bbsmith24/YamuraPyrometer/Doumentation and notes/TFT pinout back.JPG

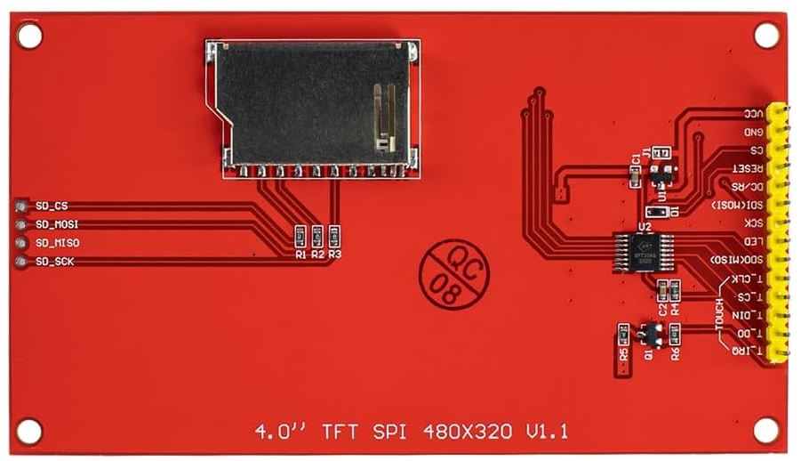
Doumentation and notes/TFT pinout back.JPG
