bbsmith24/YamuraPyrometer/Doumentation and notes/TFT pinout front.JPG

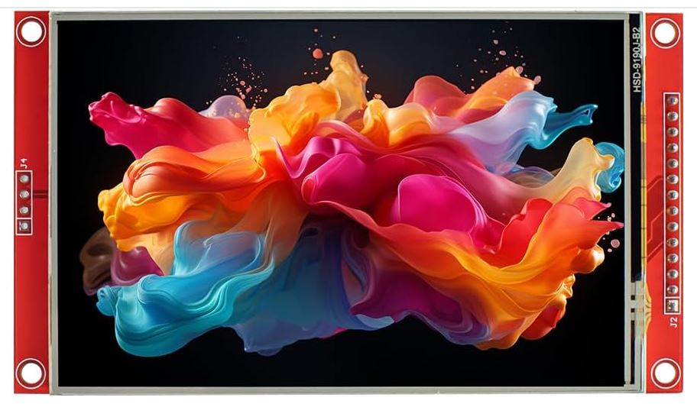
Doumentation and notes/TFT pinout front.JPG
