bbsmith24/YamuraPyrometer/Doumentation and notes/fusion schematic v2.pdf

## 4/5/2025 5:19 PM (Sheet: 1/1)

### ESP32-DEVKITC-32D

### JST-XH-2PIN

### JST-XH-4PIN

U1
3V3 J2-1 | EN J2-2 | SENSOR_VP J2-3 | SENSOR_VN J2-4

IO34 J2-5
IO35 J2-6
IO32 J2-7
IO33 J2-8
IO25 J2-9
IO26 J2-10
IO27 J2-11
IO14 J2-12
IO12 J2-13 | GND1 J2-14
IO13 J2-15 | SD2 J2-16 | SD3 J2-17 | CMD J2-18 | EXT_5V J2-19 | CLK | J3-19 SD0 | J3-18 SD1 | J3-17 IO15 | J3-16 IO2 | J3-15 IO0 | J3-14 IO4 | J3-13 IO16 | J3-12 IO17 | J3-11 IO5 | J3-10 IO18 | J3-9 IO19 | J3-8 GND2 | J3-7 IO21 | J3-6 RXD0 | J3-5 TXD0 | J3-4 IO22 | J3-3 IO23 | J3-2 GND3 | J3-1

LED LED
SDO SDO
SCK SCK | SDI SDI | DC_RS DC_RS | RESET RESET | CS CS | GND GND | VCC VCC

T_CLK T_CKL
T_CS T_CS
T_DIN T_DIN
T_DO T_DO
T_IRQ T_IRQ
SD_SDI | SD_DO SD_CS | SD_CS
SD_SDO | | SD_SCK
SD_SCK | | SD_DI
4" TFT DISPLAY A¹ A¹ SDA SDA | A² A² SCL SCL GND GND VIN VIN | A³ A³ A⁴ A⁴ ADDR ADDR
MPC9601 | 32K ³²K SQW SQW SCL SCL SDA SDA VCC VCC GND GND | SCL1 SCL1 SDA¹ SDA¹ VCC¹ VCC¹ GND¹ GND¹ | DS³²³¹

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
# 4 D1
