bbsmith24/YamuraPyrometer/Doumentation and notes/ESP32 dev kit pinout.JPG

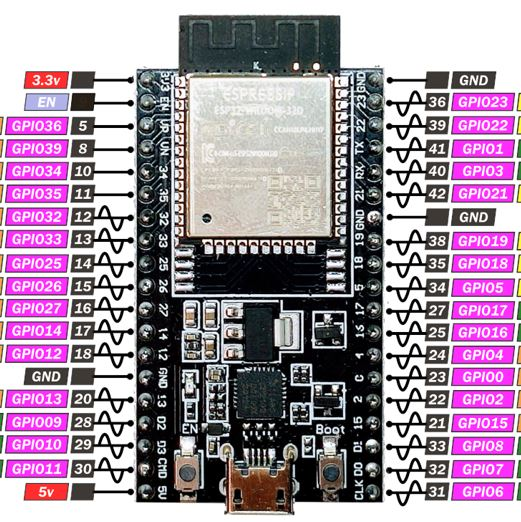
Doumentation and notes/ESP32 dev kit pinout.JPG
