bbsmith24/YamuraPyrometer/Doumentation and notes/fusion board bottom.JPG

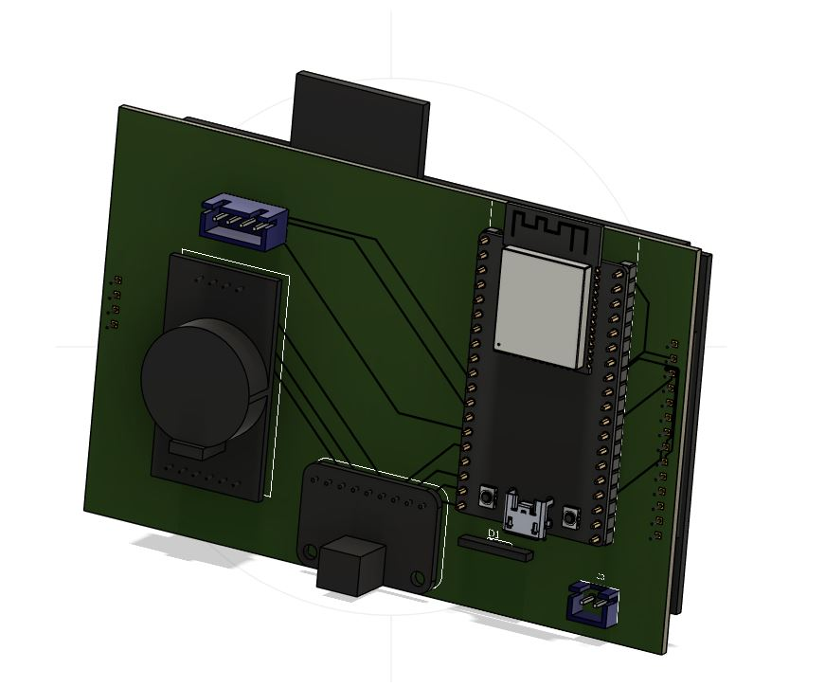
Doumentation and notes/fusion board bottom.JPG
