bbsmith24/YamuraPyrometer/Doumentation and notes/fusion board top.JPG

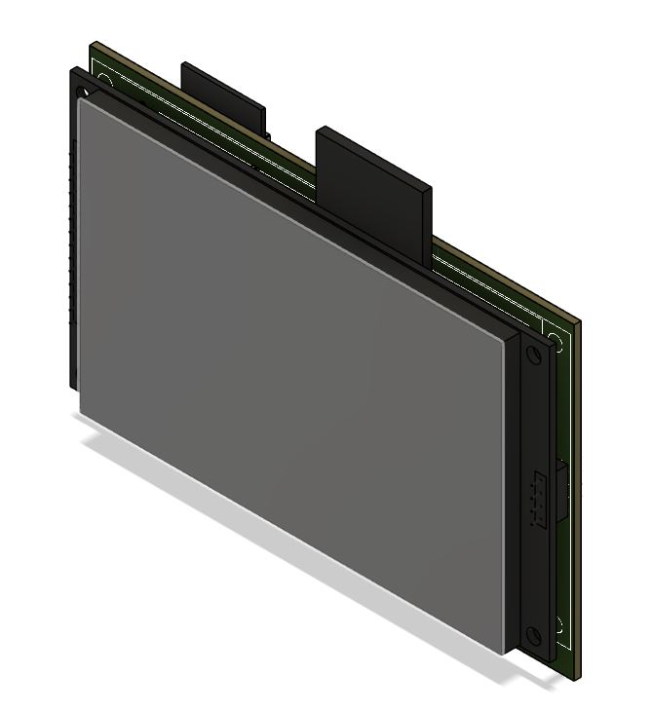
Doumentation and notes/fusion board top.JPG
