bbsmith24/YamuraPyrometer/Doumentation and notes/fusion schematic v1.JPG

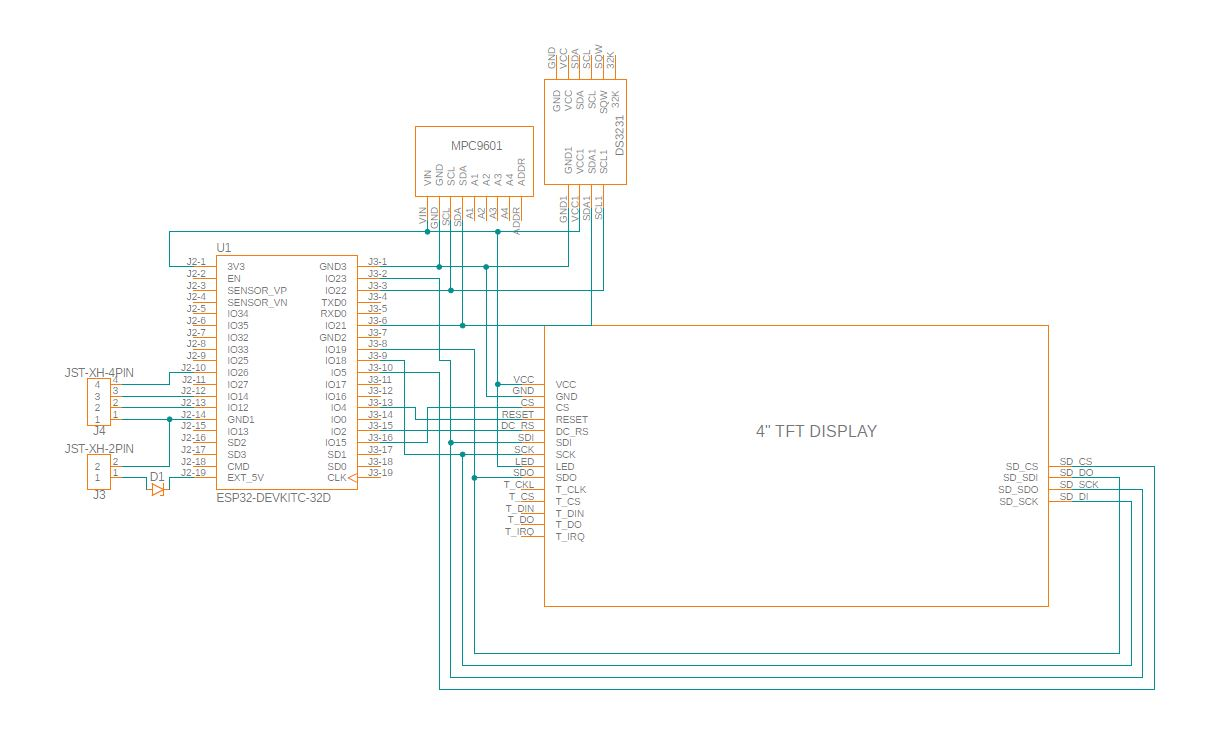
Doumentation and notes/fusion schematic v1.JPG
