bbsmith24/YamuraPyrometer/Doumentation and notes/part layout_bb.png

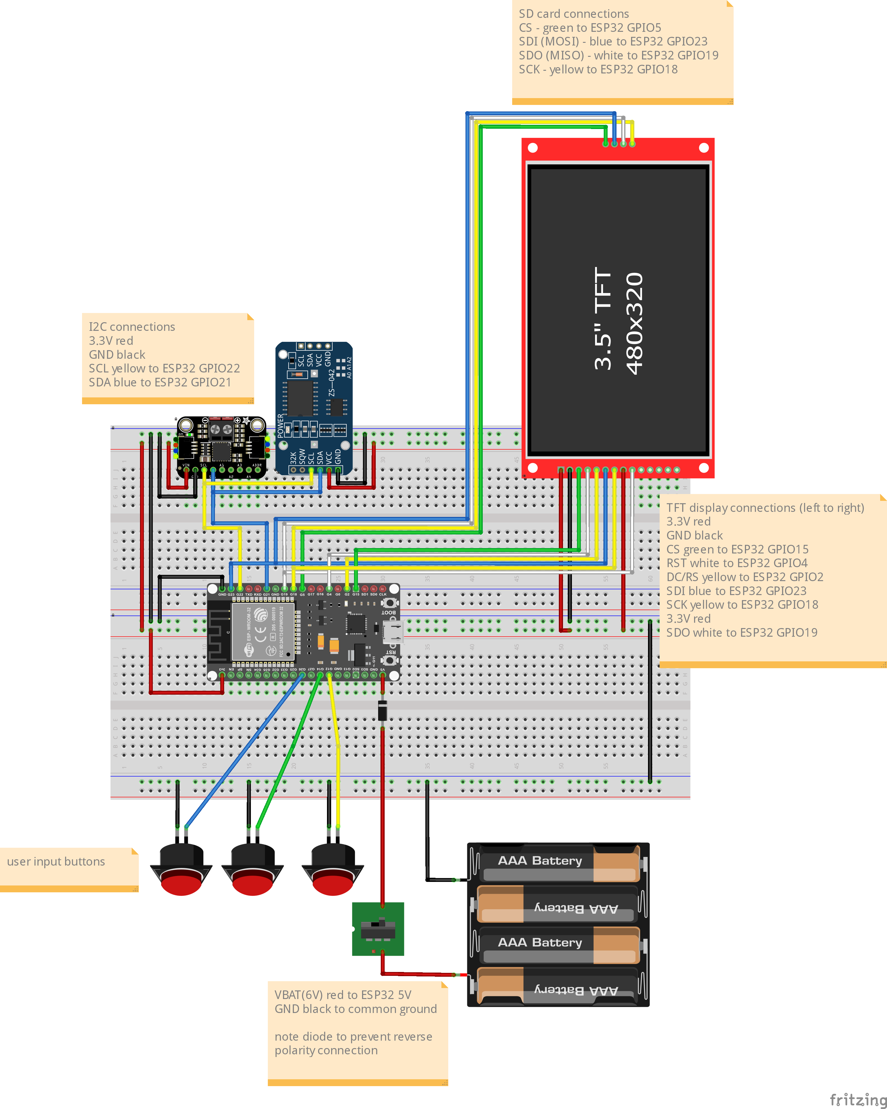
Doumentation and notes/part layout_bb.png
