bbsmith24/YamuraPyrometer/Doumentation and notes/Schematic final.jpg

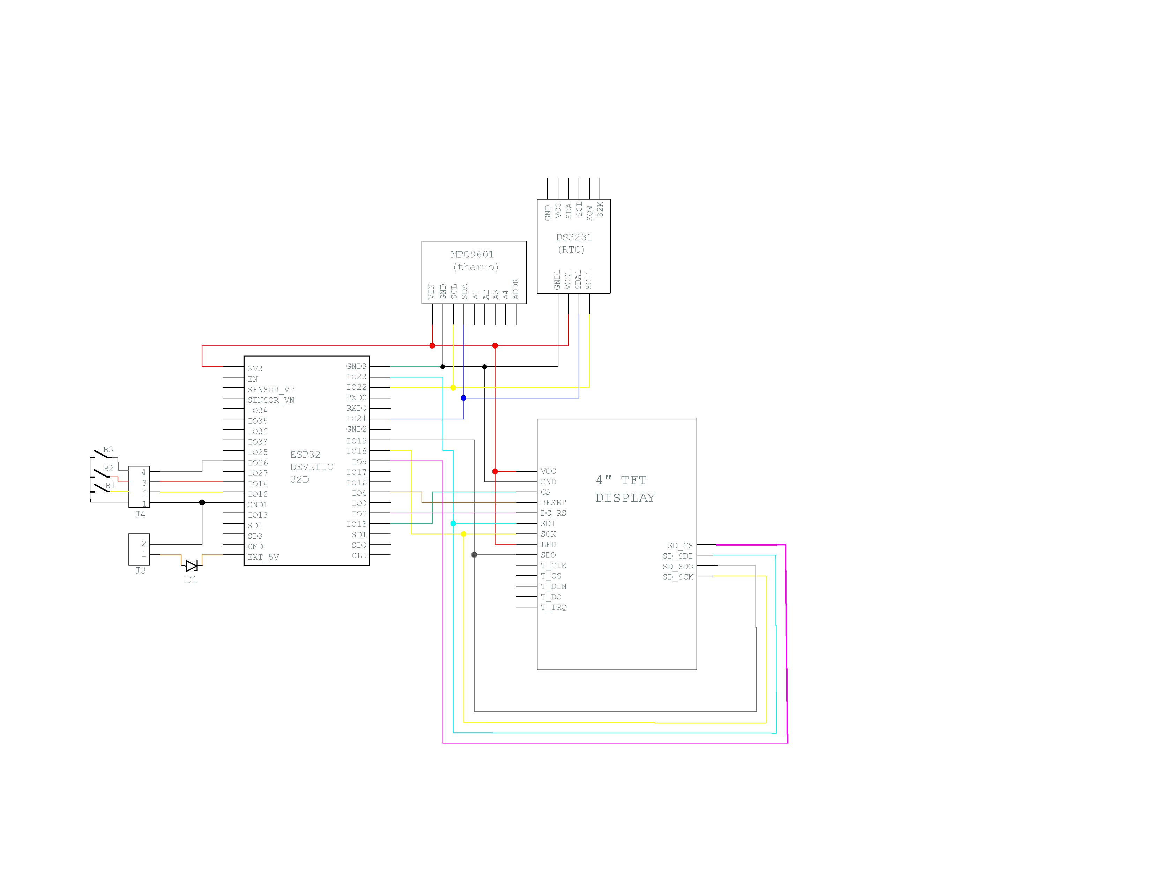
Doumentation and notes/Schematic final.jpg
