bbsmith24/YamuraPyrometer/Doumentation and notes/schematic.png

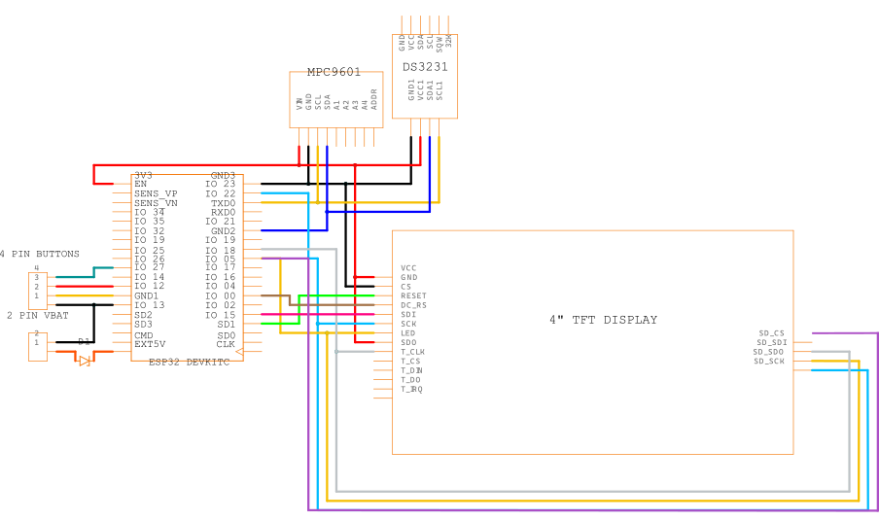
Doumentation and notes/schematic.png
