bbsmith24/YamuraPyrometer/Doumentation and notes/tire inflation.jpg

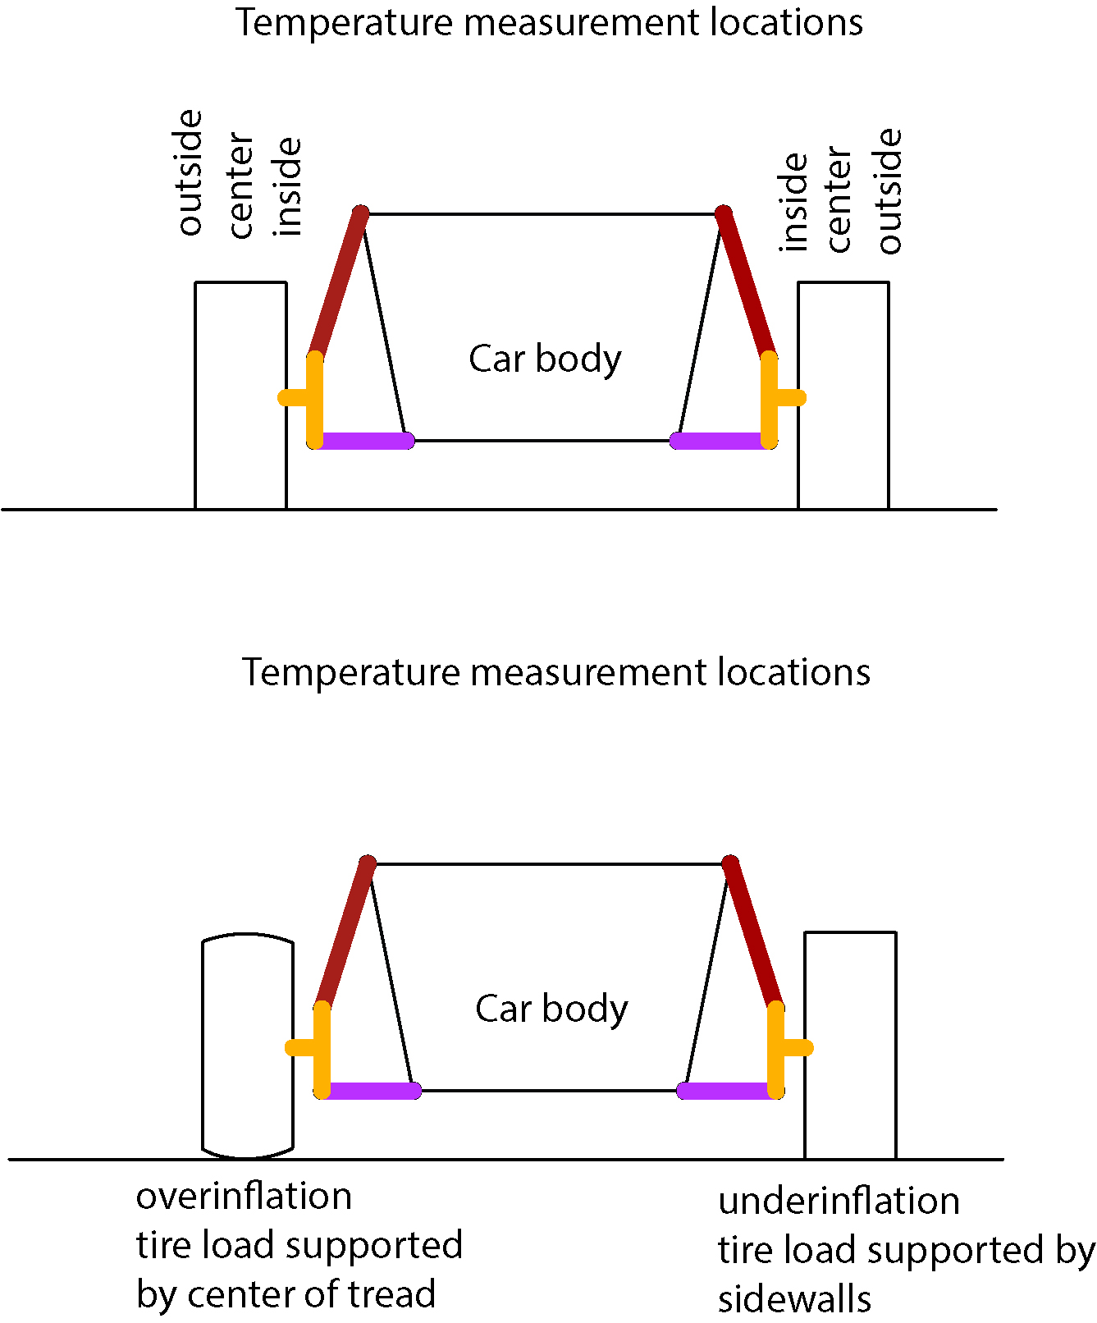
Doumentation and notes/tire inflation.jpg
