bbsmith24/YamuraPyrometer/Doumentation and notes/#fusion schematic v2.dxf

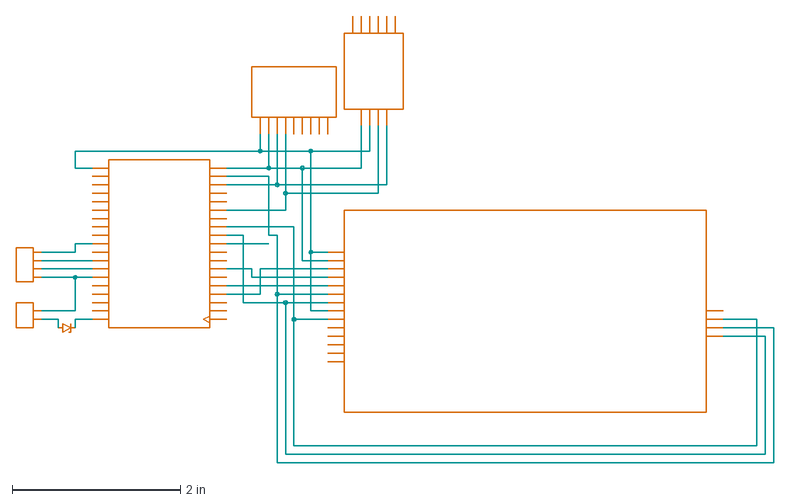
[picture p11: CAD file, 2026-07-02]
Doumentation and notes/#fusion schematic v2.dxf
9.00 x 5.30 in
