bbsmith24/YamuraPyrometer/Enclosure CAD/pyrometer box cover cover.stl

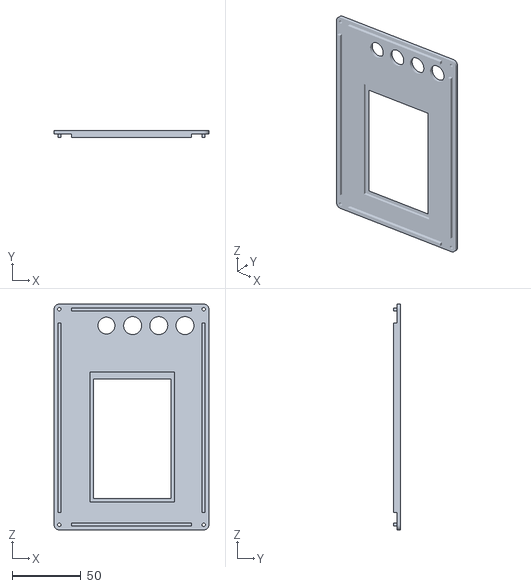
[picture p12: CAD file, 2024-07-21]
Enclosure CAD/pyrometer box cover cover.stl
112.6 x 5.08 x 164.5
