bbsmith24/YamuraPyrometer/Doumentation and notes/Hosyund 4in TFT.dxf

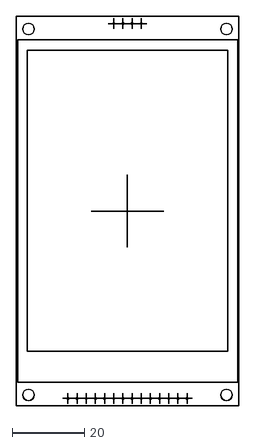
[picture p13: CAD file, 2025-02-26]
Doumentation and notes/Hosyund 4in TFT.dxf
61.7 x 108.0
