bbsmith24/YamuraPyrometer/Enclosure CAD/battery box cover.stl

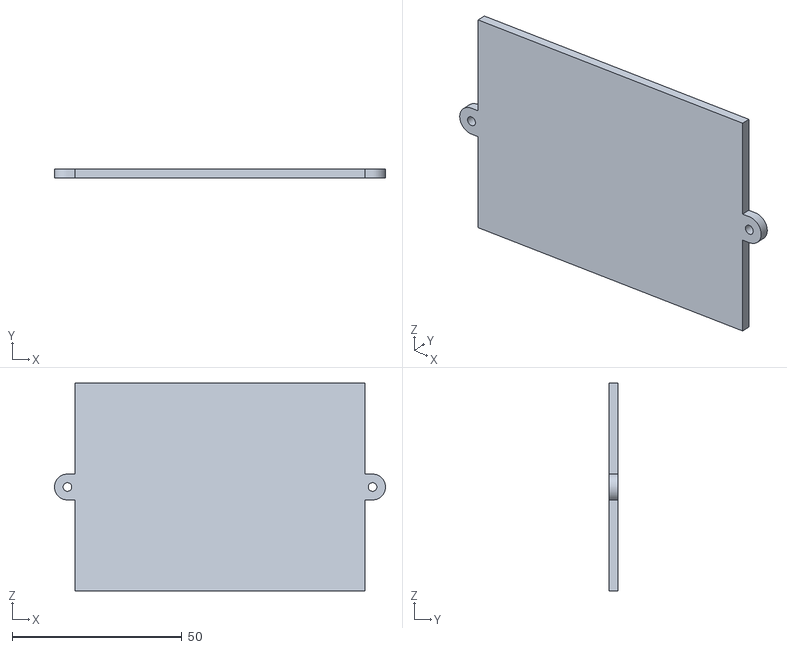
[picture p14: CAD file, 2024-07-21]
Enclosure CAD/battery box cover.stl
97.4 x 2.54 x 61.1
