bbsmith24/YamuraPyrometer/Doumentation and notes/TFT_4IN v2.step

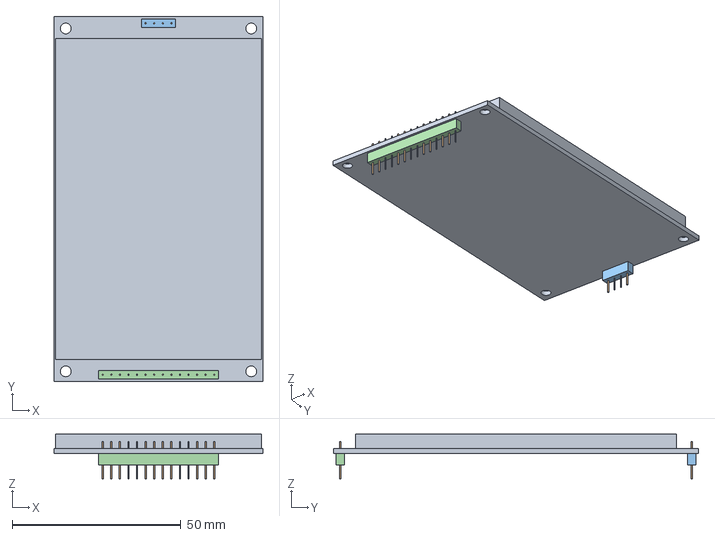
[picture p15: CAD file, 2025-02-26]
Doumentation and notes/TFT_4IN v2.step
61.7 x 108.0 x 13.2 mm
