bbsmith24/YamuraPyrometer/Enclosure CAD/pyrometer box walls.stl

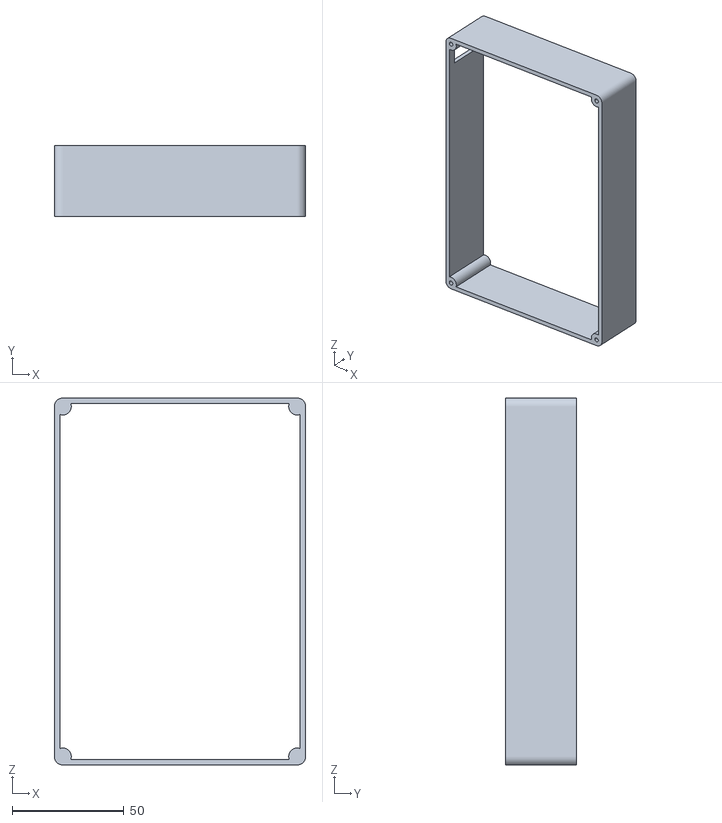
[picture p16: CAD file, 2024-07-21]
Enclosure CAD/pyrometer box walls.stl
112.6 x 31.7 x 164.5
