bbsmith24/YamuraPyrometer/Doumentation and notes/camber changes.dxf

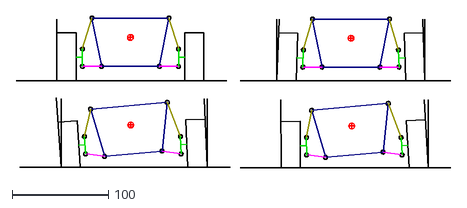
[picture p17: CAD file, 2025-02-26]
Doumentation and notes/camber changes.dxf
452.0 x 157.5
