bbsmith24/YamuraPyrometer/Enclosure CAD/battery box.stl

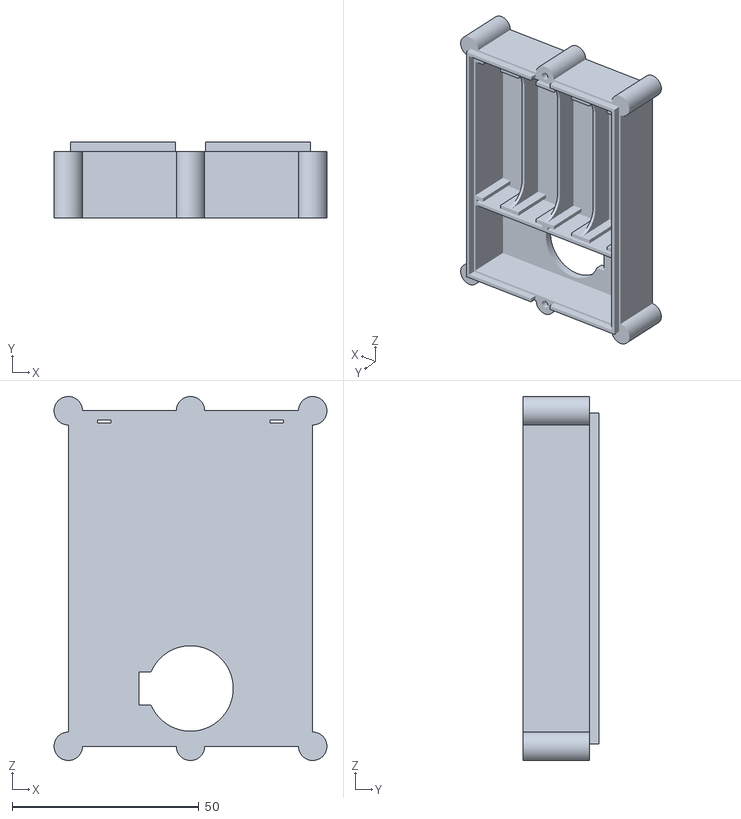
[picture p18: CAD file, 2024-07-21]
Enclosure CAD/battery box.stl
73.0 x 20.3 x 97.4
