bbsmith24/YamuraPyrometer/Enclosure CAD/pyrometer box bottom.stl

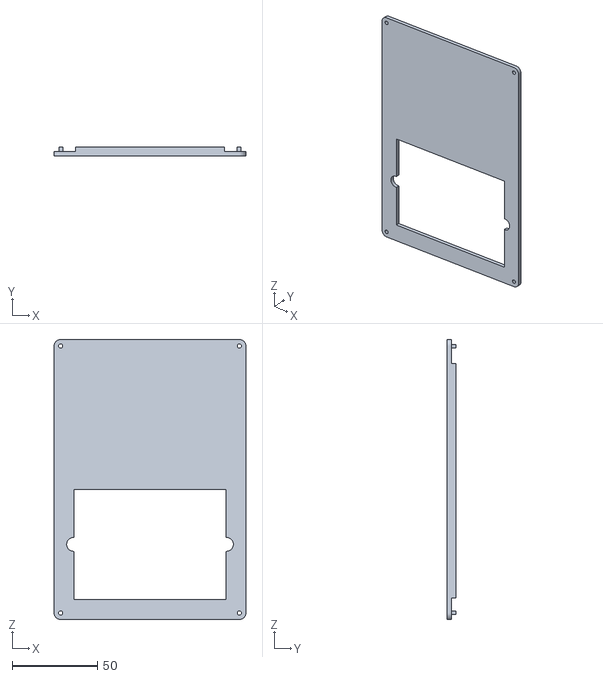
[picture p19: CAD file, 2024-07-21]
Enclosure CAD/pyrometer box bottom.stl
112.6 x 5.08 x 164.5
