bbsmith24/YamuraPyrometer/(list of files, cad)

Other CAD files:
Doumentation and notes/camber changes.dwg
Doumentation and notes/fusion schematic v2.dxf
Enclosure CAD/Yamura Pyrometer box v24.f3z
