bbsmith24/YamuraPyrometer/HTML pages/setup.txt

2
Brian Z4
4
RF
Right Front
LF
Left Front
LR
Left Rear
RR
Right Rear
3
O
Outer
M
Middle
I
Inner
==========
Mark MR2
4
RF
Right Front
LF
Left Front
LR
Left Rear
RR
Right Rear
3
O
Outer
M
Middle
I
Inner
==========
