bbsmith24/YamuraPyrometer/Doumentation and notes/camber changes.jpg

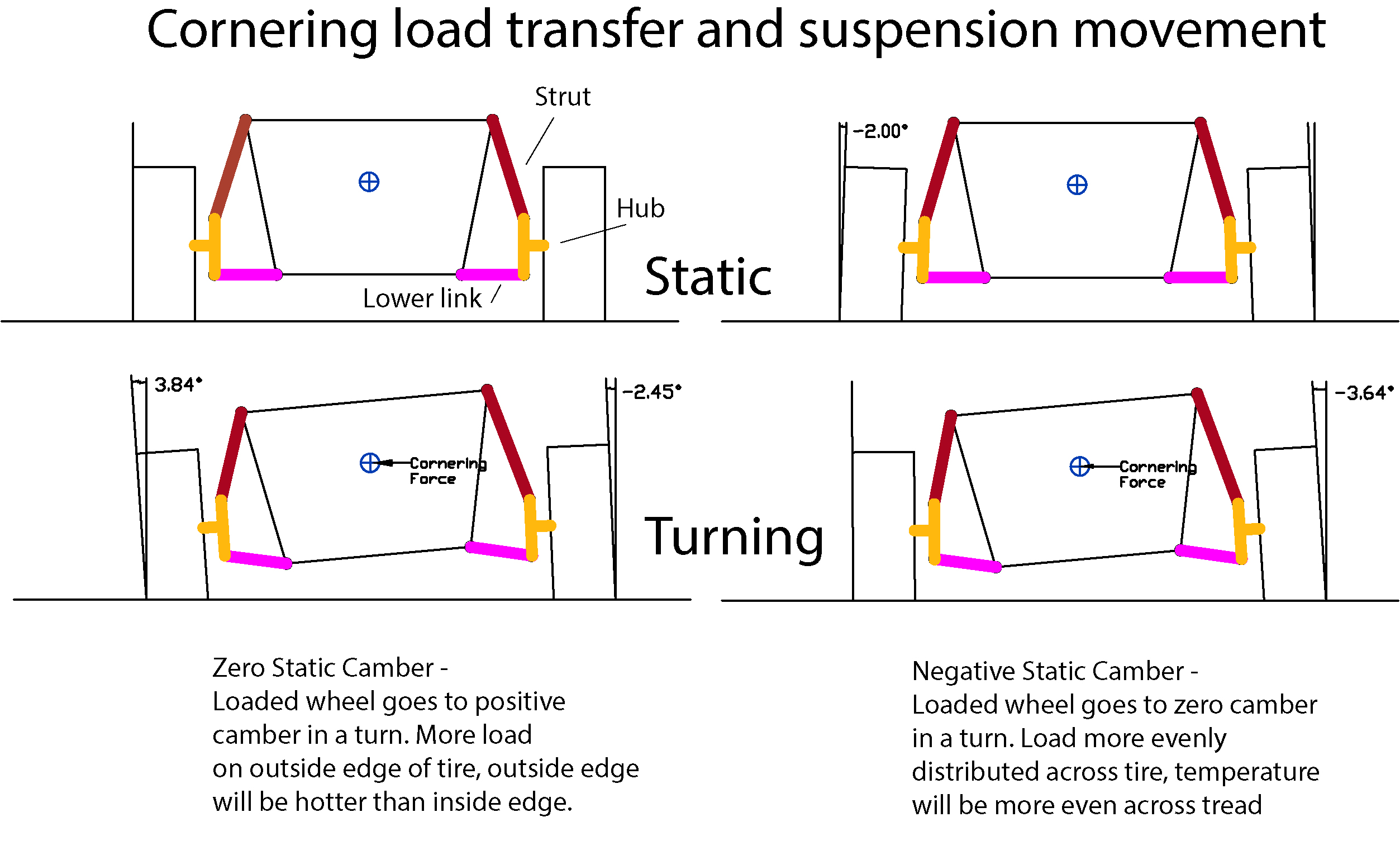
Doumentation and notes/camber changes.jpg
