bbsmith24/YamuraPyrometer/Doumentation and notes/Beta 2 board connections.pdf

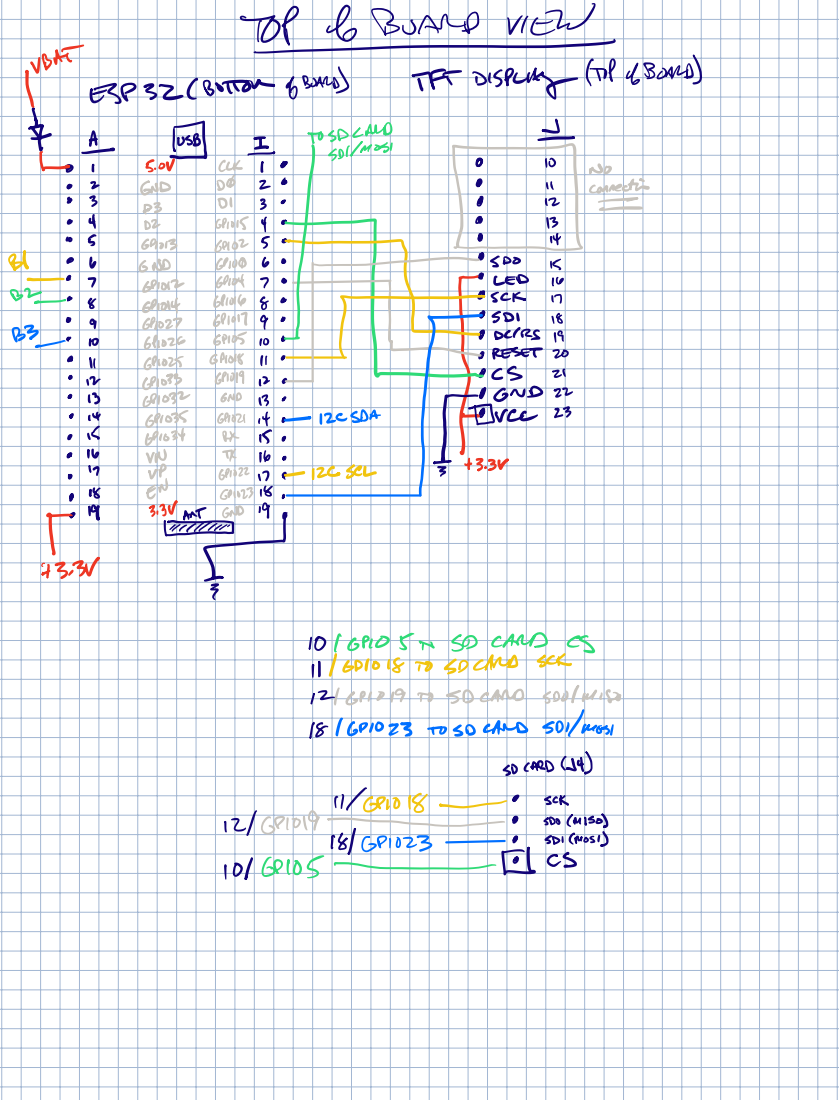
[picture p21: page 1]
PEseszcr.toBiEisiEfIaam a; TUB

ffÑ
If
601033 | | | f
Iffy 601025 | 6 | f
if

case

43 | x

1 | | 8 | 5is | aais9aces

12 681019TO SDCARD SDOMISO
18 | | 601023 TOSD CAD SDIMost

SDCARDS4

1401019 | | ÉÉ
10 | 60105

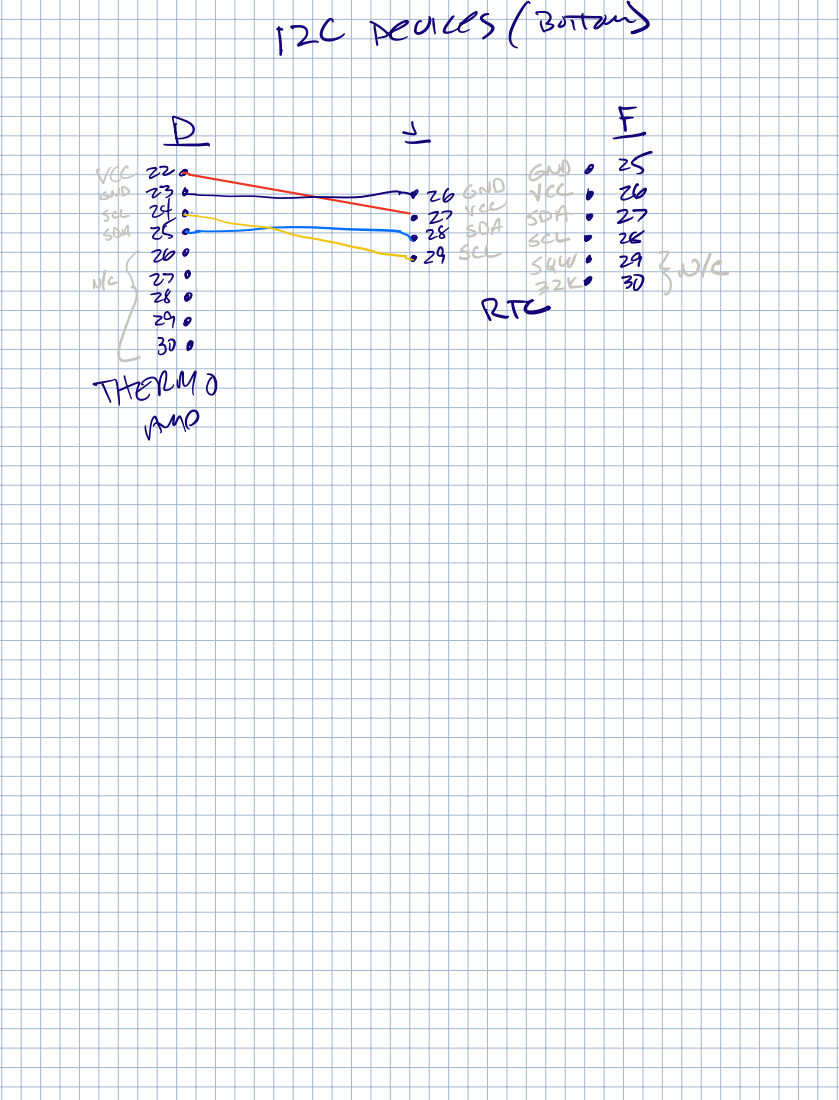
[picture p22: page 2]
Devices; Bottom

É | fzf | f | | É | 2

5k | | | wk
re

THERMO
AMP
