bbsmith24/YamuraPyrometer/Doumentation and notes/Beta 1 board notes.pdf

Iii | Iii

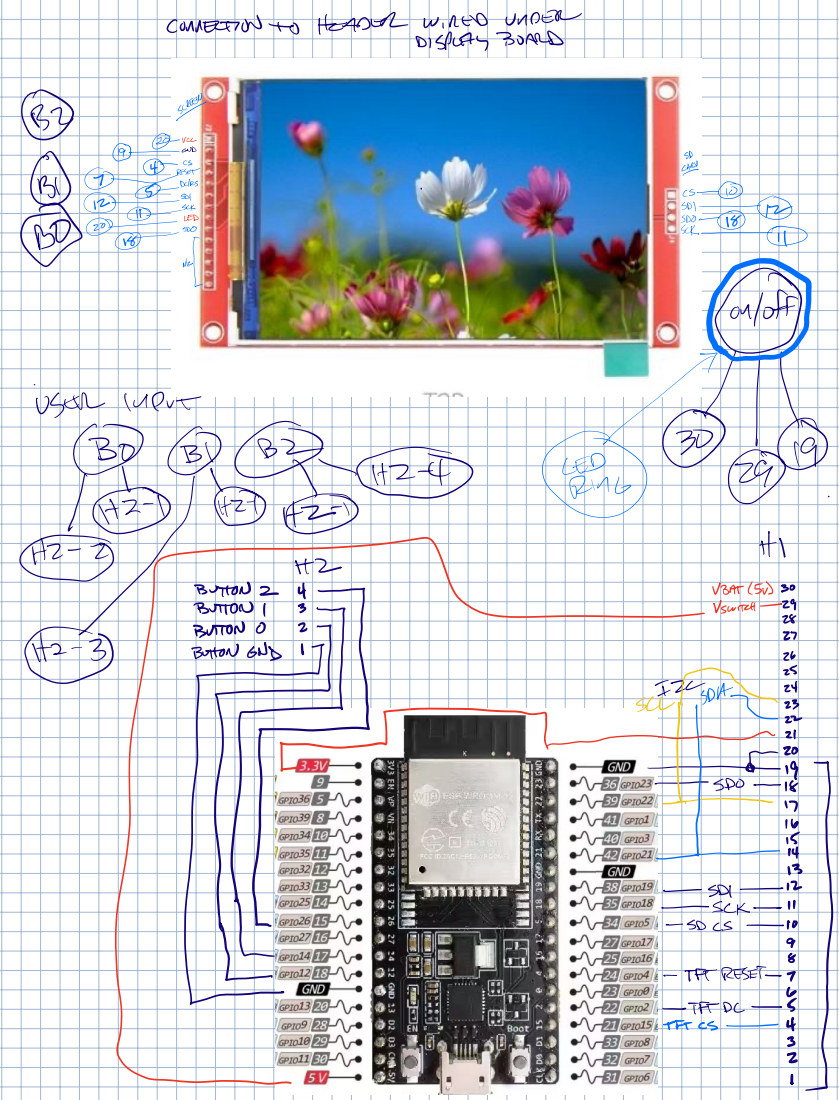
[picture p23: page 1]
CONNECTION; HEAR; SEF; HEY; user; input; fff; If IÉIIÉI

5 | 5 | 9 | 3

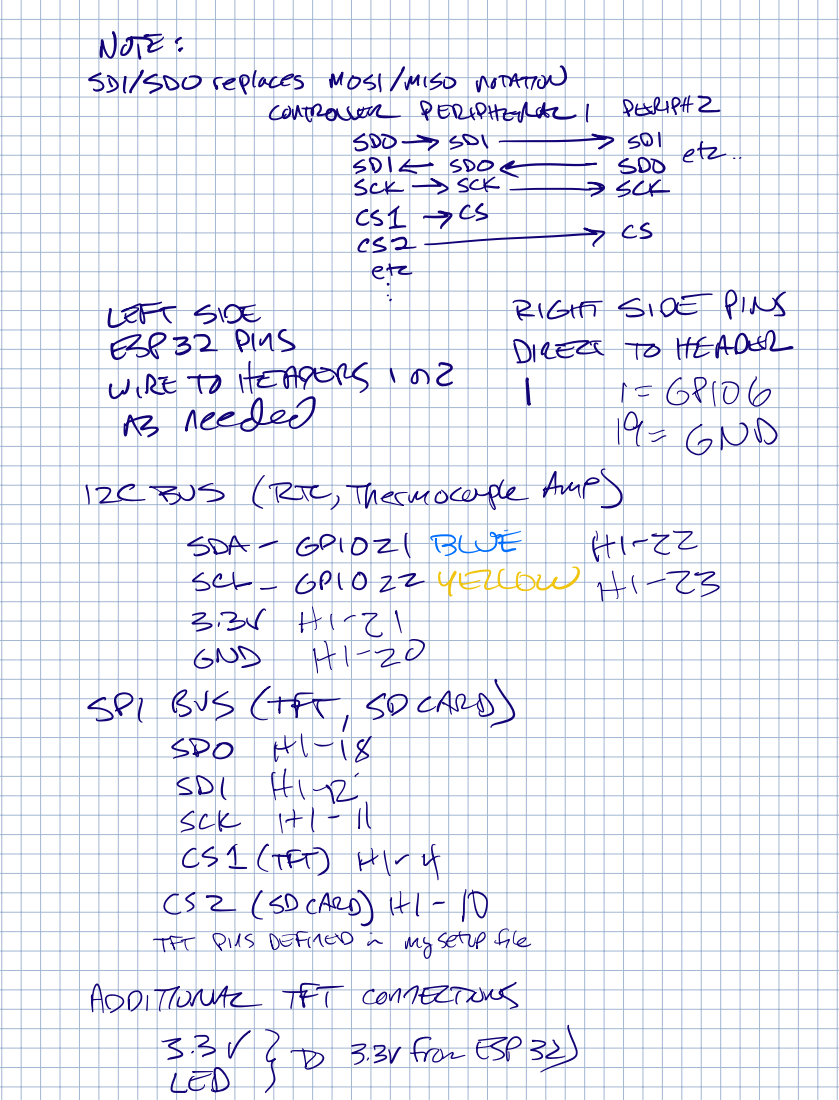
[picture p24: page 2]
NOTE; BUS; RTC; ThermocoupleAMP; SDA; BLUE; SCH; YELLOW; ADDITIONAL; TFT; COMELTONS; 3.30fromESP

SDISDO replaces | | Most | | MISO | | | NOTATION

CONTROLLER | | | | PERIPHERAL | | | PERIPHZ
SDO | | | 501 | | | 501 | etc

LEFT | | | SIDE | | | | RIGHT | | | SIDE | | | PINS
ESP | | 32 | | PINS | | | DIRECT | | | TO | HEADER
Wire | | to | | HEADENS | | 102 | | I | 1 | | 68106
As | needed | | | | | | | 19 | | | GND

3.36 | H1 | | 21
GND | | HI | | 20
SPI | BUS | | | TFT | | SD CARD
SDO | | | H1 | 18
SDI | H1 | | I
SCK | | HI | | 11
CSI | | TFT | H1 | | | 4
52 | SDCARD | | H1 | | | 10
TFT | | PIASDEFILED in | | | | mysetup file

BATTERY | POWER | TO | HEADER | | HIS | SWITA

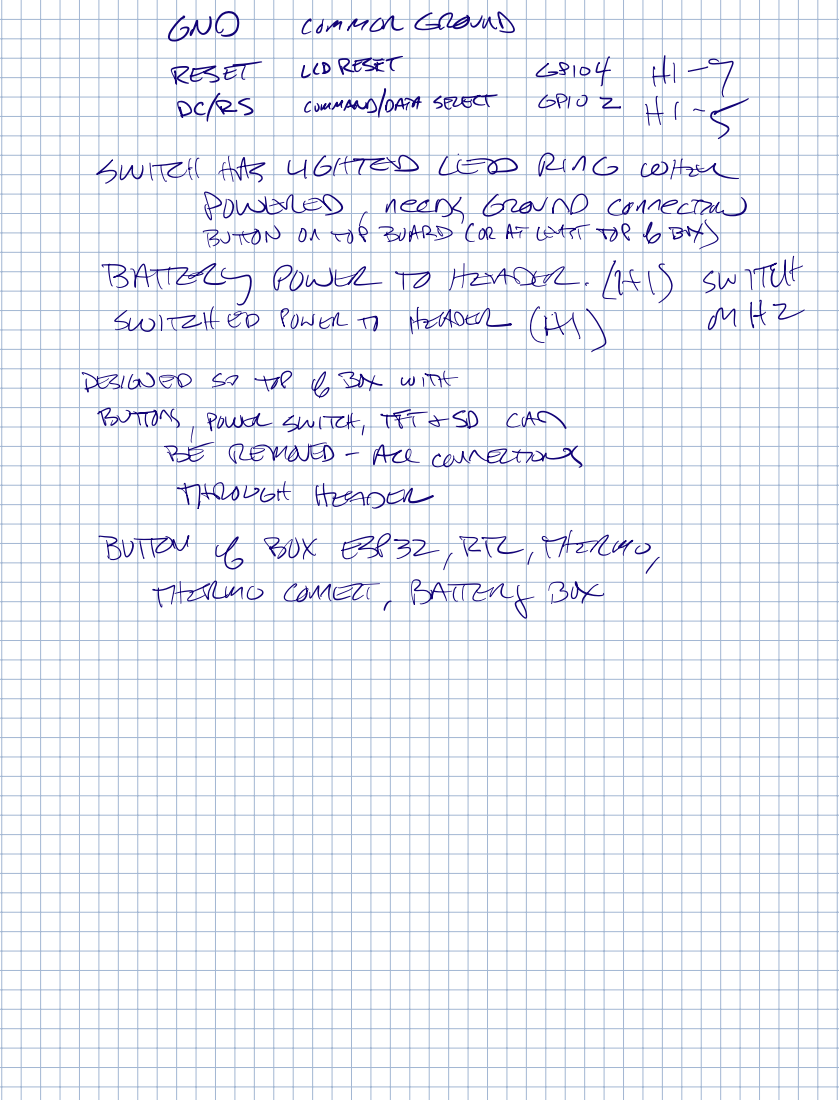
[picture p25: page 3]

GNO | | | common GROUND
RESET | | | UDRESET | 68104 | | HI | 9
DC | RS | COMMANDDATASELECT | GP | 02 | A
SWITCH HAS | | LIGHTED | | LED | | | RING | | WHEN

POWERED | | needs | | | Ground | | connection
BUTON ONTOPBOARD | | | | ORATLARTTOP 6 BN

SWITCHED POWERTO | | HEADER | | H1 | | | MHZ

DESIGNED | | SO TOP ofBOX WITH
BUTTONS | | POWERSWITCH | | | TFT | SD | CAN

BE | | REMOVED | | ALL CONNECTIONS
THROUGH | | | HEADER
BUTTON | | of | BOX | | ESP 32 | | RR | THERMO
THERMO | | | COMET | | BATERS BOX
