bbsmith24/YamuraPyrometer/Doumentation and notes/camber changes.pdf

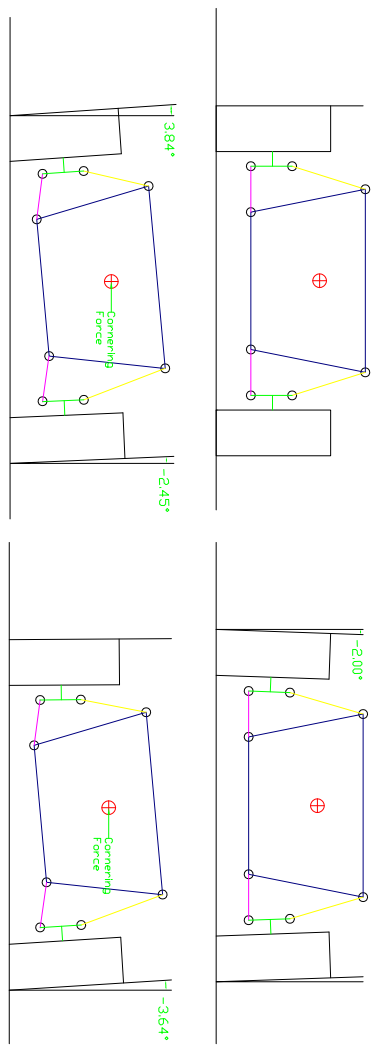
[picture p26: page 1]
