bbsmith24/YamuraPyrometer/Doumentation and notes/Note Jun 7, 2024.pdf

| | | HI

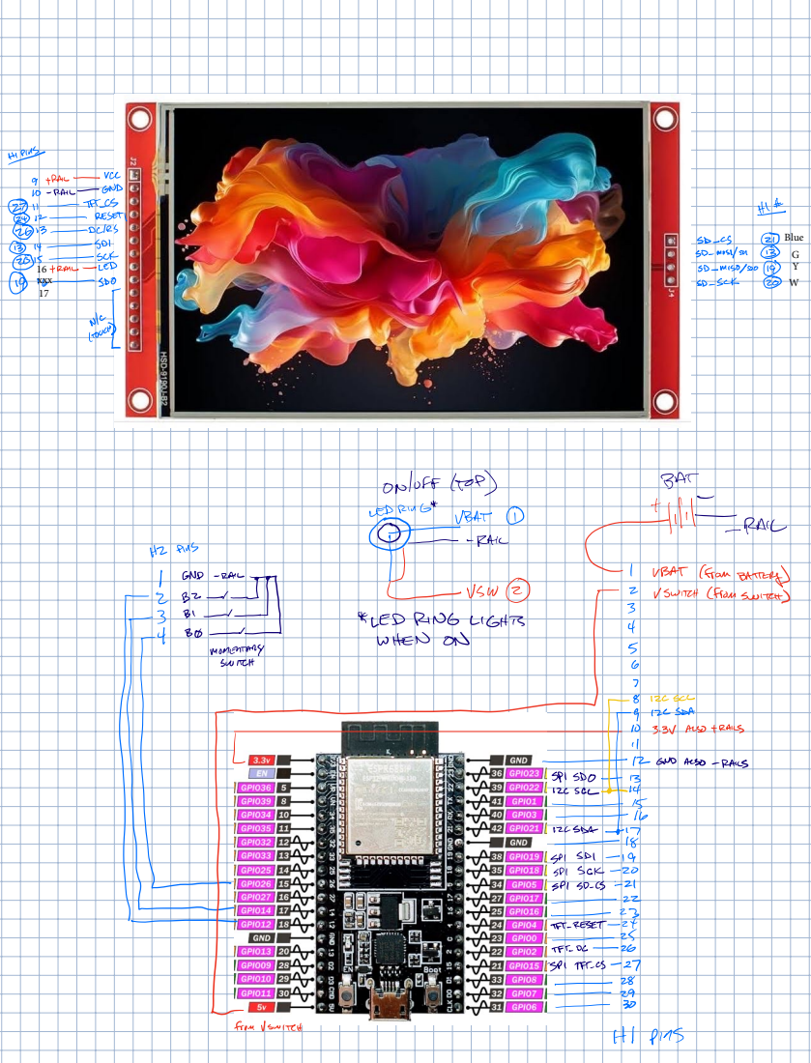
[picture p27: page 1]
ONOFFTOP; BEE; ran; LEFEE L'GHTS; resDA; iiiiiiiiiiiii.IM; fromsuited; At pins

Blue

16 | xxx | in | | | Y W
17

I | | kno

MOFFIT
