bbsmith24/YamuraPyrometer/(list of files, drawings)

Other design files:
Doumentation and notes/part layout.fzz
