bbsmith24/YamuraPyrometer/Board Layout/Yamura RTP KCad/Yamura RTP/Yamura RTP.kicad_pcb

## KiCad design Electrical Testing Suite (Hardware)/Electrical Testing Suite (Hardware).kicad_sch

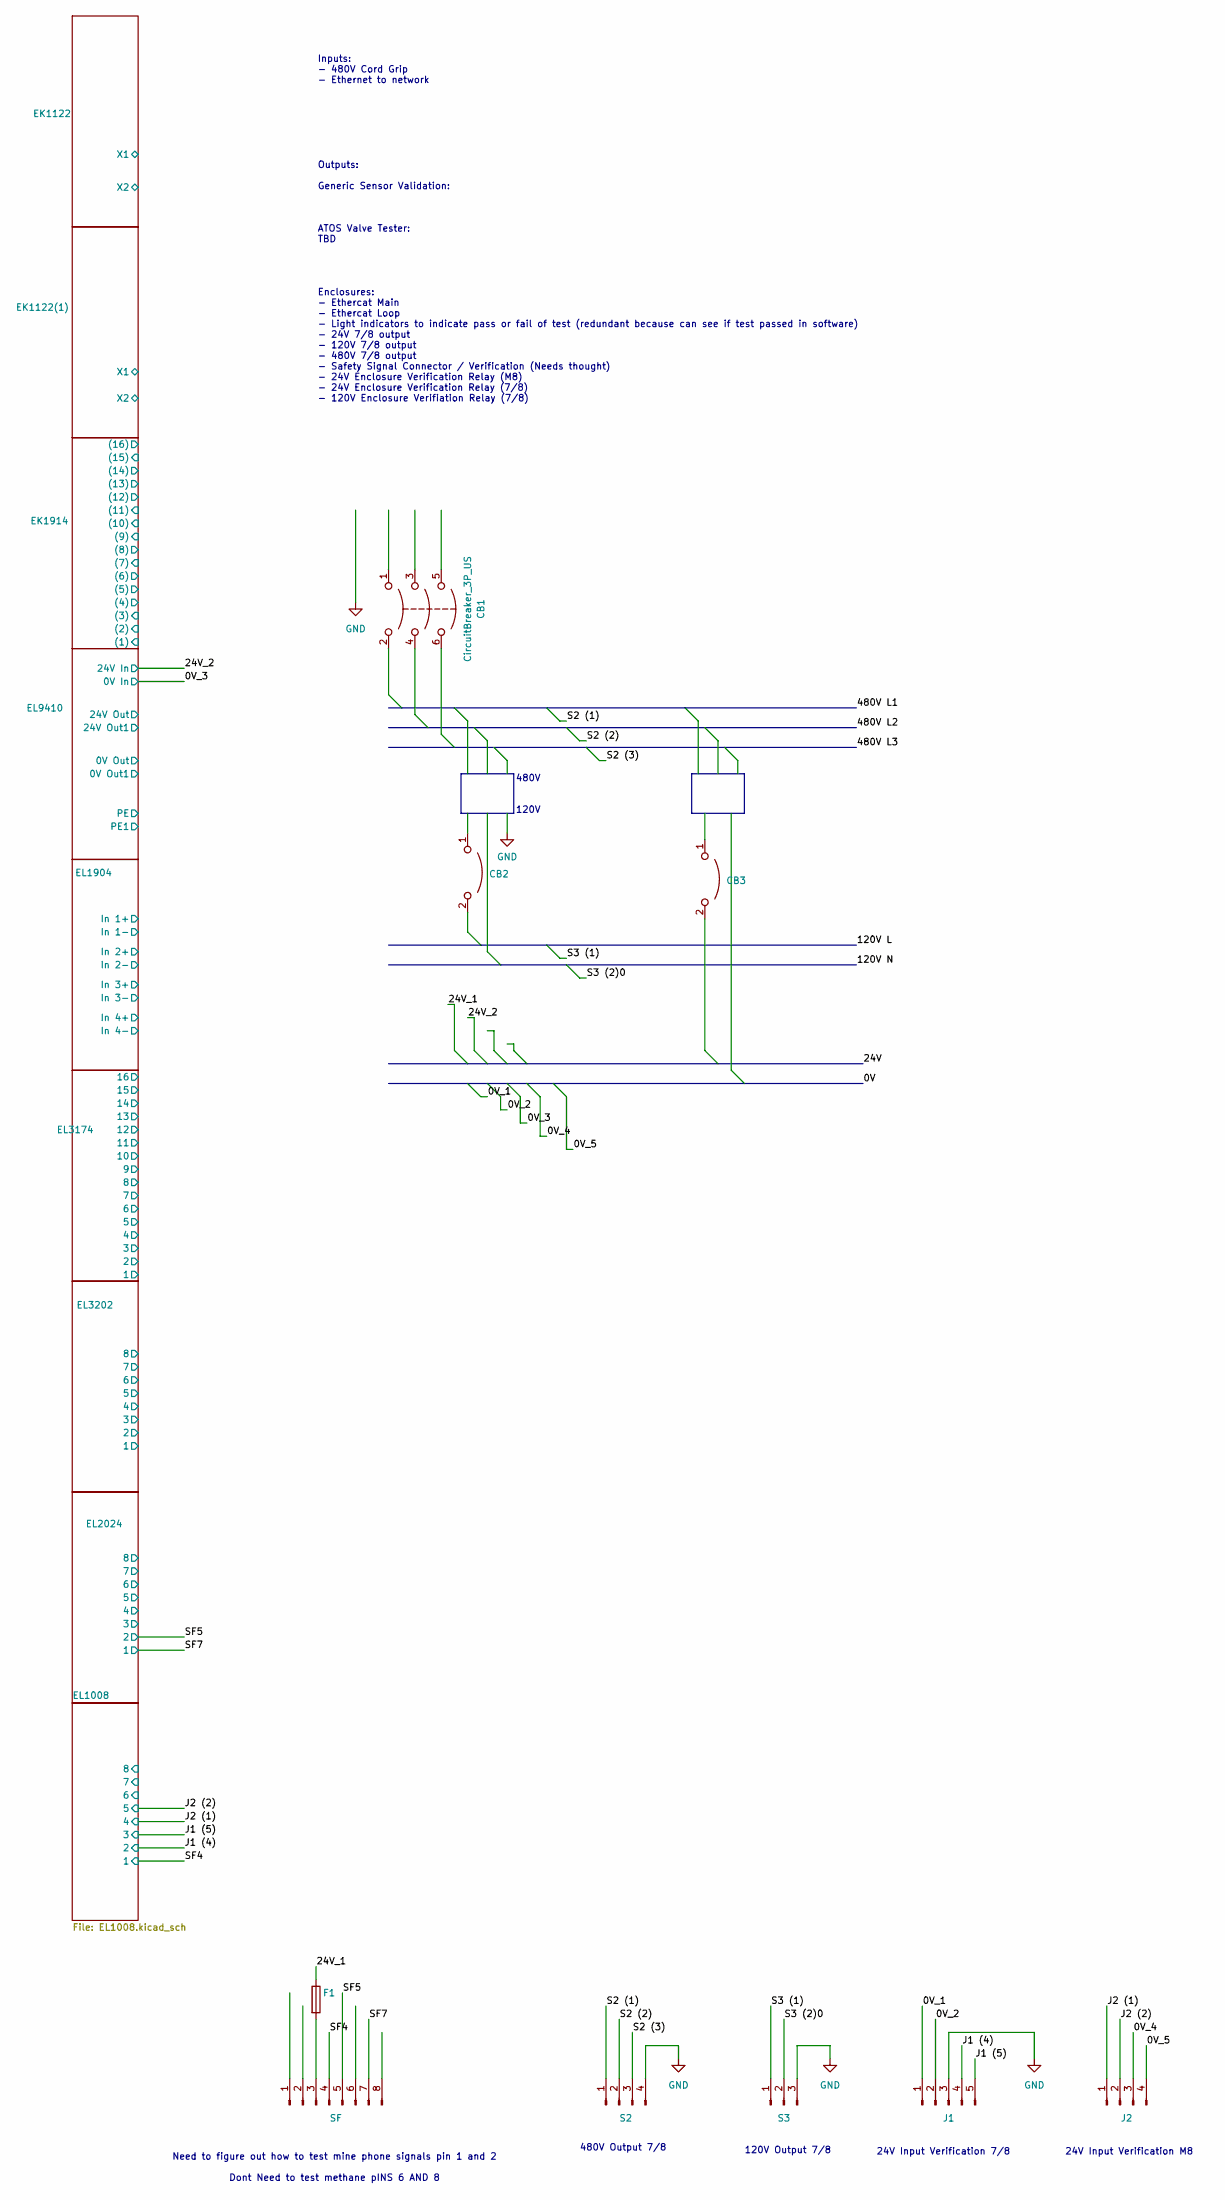
[picture p28: schematic Electrical Testing Suite (Hardware).kicad_sch]

Parts:
CB1: CircuitBreaker_3P_US
CB2, CB3: (no value)
F1: Fuse
J1: Conn_01x05_Pin
J2: Conn_01x04_Pin
S2: Conn_01x04_Pin
S3: Conn_01x03_Pin
SF: Conn_01x08_Pin

Connections:
0V_1: J1.1
0V_2: J1.2
0V_4: J2.3
0V_5: J2.4
24V_1: F1.1
GND: J1.3, S2.4, S3.3
J1 (4): J1.4
J1 (5): J1.5
J2 (1): J2.1
J2 (2): J2.2
unnamed: F1.2, SF.3
S2 (1): S2.1
S2 (2): S2.2
S2 (3): S2.3
S3 (1): S3.1
S3 (2)0: S3.2
SF4: SF.4
SF5: SF.5
SF7: SF.7

Notes on the sheet:
120V Output 7/8
120V
Inputs: - 480V Cord Grip - Ethernet to network Outputs: Generic Sensor Validation: ATOS Valve Tester: TBD Enclosures: - Ethercat Main - Ethercat Loop - Light indicators to indicate pass or fail of test (redundant because can see if test passed in software) - 24V 7/8 output - 120V 7/8 output - 480V 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
24V Input Verification M8
480V
24V Input Verification 7/8
Need to figure out how to test mine phone signals pin 1 and 2 Dont Need to test methane pINS 6 AND 8
480V Output 7/8
