bbsmith24/YamuraPyrometer/(commit log)

2023-08-25 Initial check in
    read tire temps with stability check
    [YamuraPyrometer.ino]
2023-08-29 Update YamuraPyrometer.ino
    writes to microSD
    still a couple of issues - index to temp array on text output for P34 (6 wheels)
    name for the Doctor everywhere?
    [YamuraPyrometer.ino]
2023-08-29 non-WiFi mostly complete....
    need to look at temp stabilization time, might need to put a bigger delay to allow button release to clear at start of measurement?
    add wifi page, ftp, setup (access point, or client options)
2023-08-30 added RTC and time set
    made this optional by #define HAS_RTC - if not set RTC not accessed, use millis() for recording time
2023-09-01 added units, delete file
    settings (time, units, delete) as a submenu
    changed data for MenuSelect to a structure - should really be a class so I don't have to make the choices list a global to avoid frequent size redefinitions (and possible memory leaks), but it's OK as is
    Could be 'production' firmware except for WiFi interface that would solve the 'open the box to change settings file and download data' problem
    Looked at ESP32 deep sleep, but with the peripherals still drawing power battery life wouldn't have been great, found some cheap ones on Amazon to replace the more expensive Sparkfun version so it doesn't add a lot to the cost...
    [YamuraPyrometer.ino]
2023-09-05 bigger screen
    switched to bigger screen, use highlight to indicate selection instead of '>', list results to screen for selection (still need to parse into a structure for display). menu display cleanup
    added a sample data file, html file to display results in a table (thanks ChatGPT!). Still need to add website update from ESP32...
2023-09-07 selected result to screen
    works, cleaned up serial.print behind #ifdef DEBUG_VERBOSE
    added timestamp to car structure, filled on measurement or load from file. not used in selection
    annoying flicker of 2 wheels before starting measurement, find that
    On to WiFi host and web page
2023-09-09 updates
    write html, show driver name instead of 'Select Car' so you can skip if it's right (and moved to 2nd choice)
    sample html files
    [YamuraPyrometer.ino]
2023-09-11 added max temp for html file
    define max temp for each tire in setup, highlight in red in HTML
    red = over
    yellow = max if not over
    green = min
    no color >main < max
2023-09-12 Update YamuraPyrometer.ino
    OK, really the final update before prototype 2 hardware and box
2023-09-12 fixed (I think) temperature array indexing
    for a 1 dimensional array, simulate 2 dimensional table by
    int xSize = 4;
    int ySize = 6;
    int array[24];
    int counter = 0;
    for(int x = 0; x < xSize; x++)
    {
    for (int y = 0; y < ySize; y++)
    {
    array[(x*ySize + ySize] = counter;
    counter++;
    }
    }
    array should be
    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
    [YamuraPyrometer.ino]
2023-09-15 Update YamuraPyrometer.ino
    changes to make pins easier to get to for prototype box, changed up/down button order to match up and down on box
2023-09-16 Update YamuraPyrometer.ino
    added 'instant temp'' to display current temp at probe, any button to exit. Not recorded
2023-09-20 Update YamuraPyrometer.ino
    changed 'record' to 'arm' - put probe in tire, press arm, records and goes to next when temp stabilizes. should be faster/easier to use
    eliminate unneeded 'ready' LED. might go back for indicator of state, or could use the power button LED
2023-09-25 Update YamuraPyrometer.ino
    sort HTML output by car/driver, then date/time (write to car/driver index data files py_temps_n.txt). Limited to 100 car/driver entries, seems large enough not to cause a problem.
    Could make the file index part of the setup file too...
    [YamuraPyrometer.ino]
2023-09-25 Update YamuraPyrometer.ino
    fixed date/time set issues.
    [YamuraPyrometer.ino]
2024-02-14 not done yet...
    changed to 4" tft display, change tire display to all 2/3/4/6 in grid to use space available
    lots of changes...
    Free_Fonts.h and mySetup_ST7796_ESP32.h used by the TFT_eSPI library
2024-02-14 ready to refactor
    refactor for better measurement display in grid
    need to look at HTML file generation, not creating correct structure
    more cleanup
    [YamuraPyrometer.ino]
2024-02-14 Update YamuraPyrometer.ino
    fixed HTML generation
    on to refactoring
    [YamuraPyrometer.ino]
2024-02-18 Update YamuraPyrometer.ino
    changed double button push to select and arm a tire; need to fix **** overwriting recorded temp - probably just skip that tire?
    [YamuraPyrometer.ino]
2024-02-19 Update YamuraPyrometer.ino
    arms on select, prior/next tire skips anything measured already, can only leave tire before first measurement, when all are measured only 'done' is selectable
    [YamuraPyrometer.ino]
2024-02-20 Update YamuraPyrometer.ino
    menu line count based on screen height
    all menus to 12pt font
    add car to results selection
    invert display and reverse buttons for right or left hand use
    [YamuraPyrometer.ino]
2024-02-20 Update YamuraPyrometer.ino
    change button count to 3
    fix settings menu to show Exit option
    [YamuraPyrometer.ino]
2024-02-24 Update YamuraPyrometer.ino
    save settings
    adjust font sizes
    some fixes and cleanup
    [YamuraPyrometer.ino]
2024-02-24 Update YamuraPyrometer.ino
    fixed initial screen orientation to not whack buttons
    [YamuraPyrometer.ino]
2024-04-04 Update YamuraPyrometer.ino
    update get stable temp in tire measurements, change back to MCP9600 thermocouple amp for I2C - the SPI one wasn't happy sharing bus with microSD...
2024-04-04 Update YamuraPyrometer.ino
    missed a ';', missed am/pm or (24h) output
    [YamuraPyrometer.ino]
2024-04-05 Update YamuraPyrometer.ino
    changed selection highlight test to black on yellow
    highlight value in date/time set being changed instead of undertext
    ready to start working on board layout!
2024-05-27 just when you thought you were done...
    added 2 setup pages to HTML - one for the car setup file, one for the device setup file. No need to open the case to pull the SD card, or leave an opening for USB access to the board to update these files.
    This also required implementing LittleFS to put the setup and results HTML files in LittleFS for direct access by the web page server.
    changed malloced pointers for settings tire and position info to fixed arrays - just easier at the expense of a little more memory use
    Ready for Beta test of new hardware/software!
    [YamuraPyrometer.ino]
2024-05-27 Update YamuraPyrometer.ino
    forgot to take out the screen invert
    [YamuraPyrometer.ino]
2024-05-28 Update YamuraPyrometer.ino
    OK, I can't stop making changes LOL
    Added a raw text results box and Copy Data button to the results page - allows user to copy data for paste to doc, spreadsheet, etc.
    Changed 'AppendFile' for fileOut.println - since this doesn't require file open/write/file close for each line of text it should be faster
    Need to look at how I'm saving measurement data files - add tire and position info since it could change between measurements or the car info could even be deleted or reordered. Right now it assumes that the car setup info doesn't change between measurements on the same selected car
    [YamuraPyrometer.ino]
2024-05-28 cleanup/organization
    broke out headers, defines, function signatures, globals into 'YamuraPyrometer.h" to make the .ino file a little easier to deal with
    reordered funtions by functional group - ui, setup and results file processing, tire measurement and display, and 'common' functions like file read/list/append/delete, RTC functions, temperature unit conversion, etc
    No functional changes
    [YamuraPyrometer.h, YamuraPyrometer.ino]
2024-05-29 output results
    refactoring (write results in WriteMeasurementFile for consistency with others (read, write, writeHTML)
    added carID to car settings - if a car is deleted from settings, results for cars measured after deletion will still be written to the correct measurements file based on carID, not position in cars list
    added section header (car name, tire/position values) to raw text output. tire/position order can get messed up if the user edits it after some measurements have been taken with the old setting, but seems unlikely and can warn about it in the documentation
    [YamuraPyrometer.h, YamuraPyrometer.ino]
2024-05-29 Update YamuraPyrometer.ino
    code cleanup, fixed <\table> to </table> in car setup html
    [YamuraPyrometer.ino]
2024-06-11 soldered board version
    changed to Adafruit MPC9600 library (Sparkfun library wasn't dealing with the amp and the new RTC module well) and some changes required for different thermocouple functions, added a check loop for SD card, write HTML files to LittleFS (for serving to browser) and SD card (for backup)
    Added documentation and HTML files used for browsing
2024-06-12 ready for beta testers!
    final beta firmware, plus sample HTML files
2024-07-21 added Fusion and STL files
    .f3z is the Autodesk Fusion export file of the model
    STL files for 3D print slicer
    also changed order of buttons in code
    [Yamura Pyrometer box v24.f3z, battery box cover.stl, battery box.stl, pyrometer box bottom.stl, pyrometer box cover cover.stl, pyrometer box walls.stl]
2024-07-31 post beta 1 changes
    reverse color (black text on white or color background) to improve visibility at track, only show current tire/position when measuring temps (this was the worst case for visibility)
    [YamuraPyrometer.h, YamuraPyrometer.ino]
2024-09-06 temp stabilization and some bug fixes
    added bandwidth, buffer size, and measure delay to allow changes to temp stabilization function
    only use SD card
    use carID for results file name when displaying selected driver results (was correct everywhere else)
    [YamuraPyrometer.h, YamuraPyrometer.ino]
2024-09-06 temp stabilization
    change temp buffer initialization value to something closer to a likely temperature, should speed up stabilization. Also show current average on measure screen
2024-09-15 add fritzing schematic
    schematic and screenshot
    [part layout.fzz]
2024-09-29 Create Beta 2 board connections.pdf
    updated board layout for doublewide Electrocookie
2025-02-26 updates
    updates
    [Hosyund 4in TFT.dxf, TFT_4IN v2.step, Yamura RTP.kicad_pcb, Yamura RTP.kicad_sch, camber changes.dwg, camber changes.dxf]
2025-03-02 added ElegantOTA
    added Elegant OTA, 'update' button on main page, reformatted results page to make buttons bigger and at bottom of page
    Note: for Elegant OTA to work with this, change #define ELEGANTOTA_USE_ASYNC_WEBSERVER 0 to #define ELEGANTOTA_USE_ASYNC_WEBSERVER 1 in ElegantOTA.h file in library
2025-03-05 ElegantOTA updates
    added ElegantOTA. Firmware uploads and reboots RTP.
    Data files area copied to the LittleFS file system, then copied to the SD card on boot and deleted from LittleFS. Allows you to update data (*.txt), py_main.html, setup.txt and style.css files wirelessly.
    [YamuraPyrometer.h, YamuraPyrometer.ino]
2026-07-02 documentation updates
    preparing for MAKE article
    [#fusion schematic v2.dxf, Yamura RTP.kicad_pcb, Yamura RTP.kicad_sch, fusion schematic v2.dxf]
2026-07-03 changed highlight text color for hot/cold display #1
    also fixed changes in the TFT library files - either an update snuck by me or I changed something when using a Teensy. In any case, I had Claude preserve changes to fix it in the TFT_Library folder #1
    [User_Setup.h, YamuraPyrometer.h, YamuraPyrometer.ino, mySetup_ST7796_ESP32.h]
2026-07-03 code cleanup
    commented out DEBUG_VERBOSE, all serial output in #ifdef/#endif so it doesn't show up. Not really a big deal, just a little speed
    [YamuraPyrometer.h, YamuraPyrometer.ino]
